Stefan1623/VoidLink_Hardware/RP2350_V2/JLCPCB_stackup_info.png

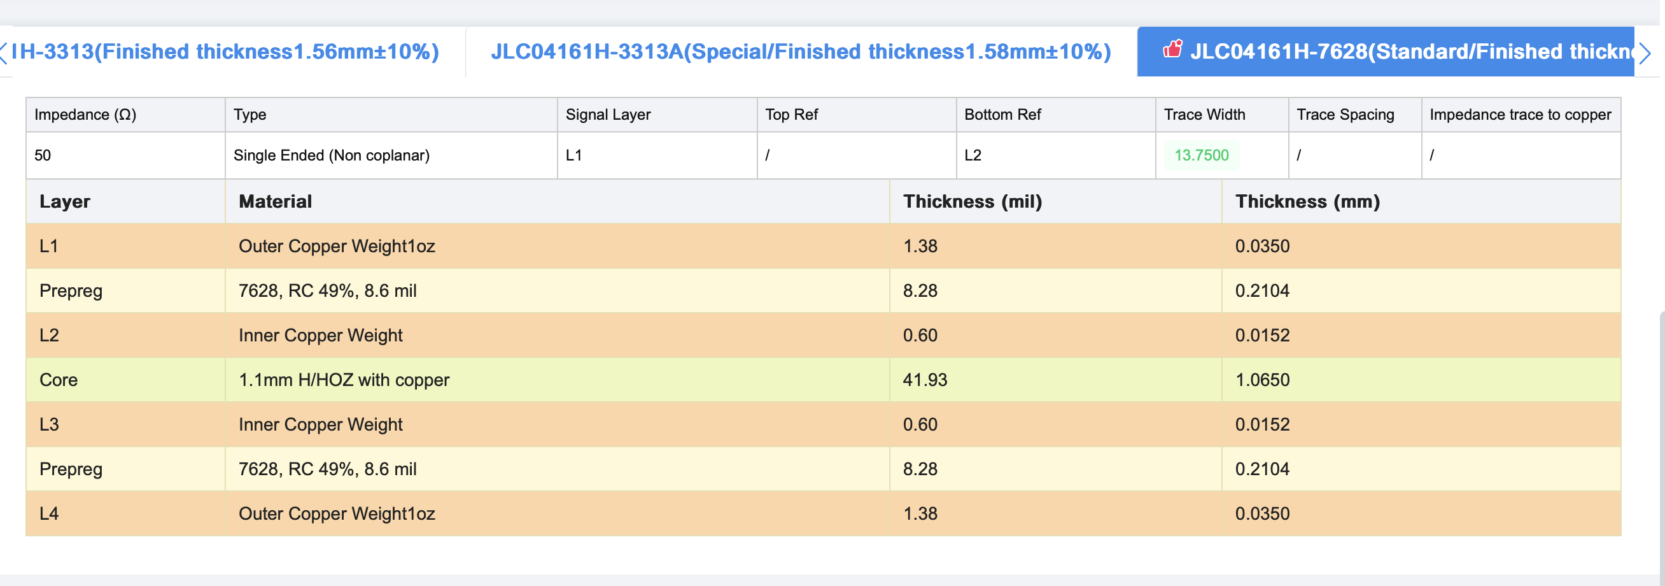
RP2350_V2/JLCPCB_stackup_info.png
