Stefan1623/VoidLink_Hardware/RP2350_V2/3dmodels/My_Caps/CAP_CL05_SAM.step

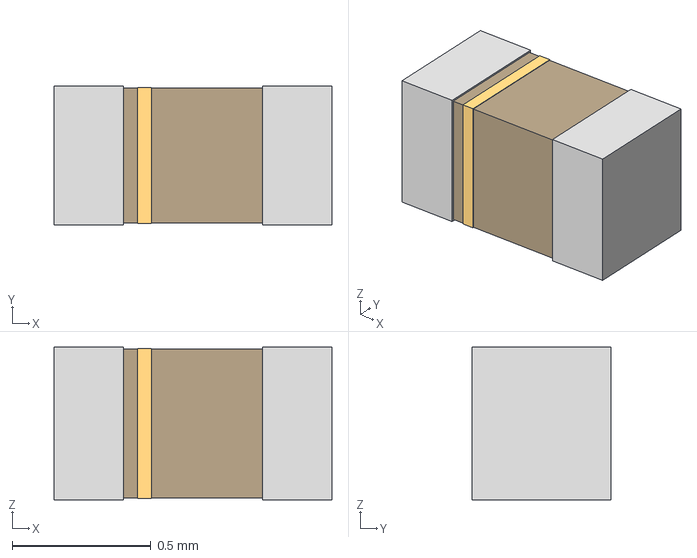
[picture p2: CAD file, 2025-02-19]
RP2350_V2/3dmodels/My_Caps/CAP_CL05_SAM.step
1.00 x 0.5 x 0.55 mm
