Stefan1623/VoidLink_Hardware/RP2350_V2/3dmodels/My_ESD/SMFSeries_LTF.step

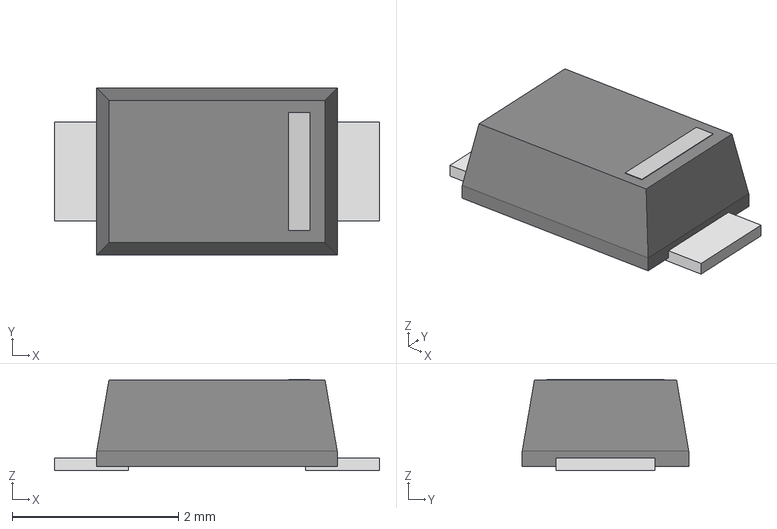
[picture p3: CAD file, 2025-02-19]
RP2350_V2/3dmodels/My_ESD/SMFSeries_LTF.step
3.91 x 2.01 x 1.10 mm
