Stefan1623/VoidLink_Hardware/RP2350_V2/3dmodels/My_ICs/DCK0006A.stp

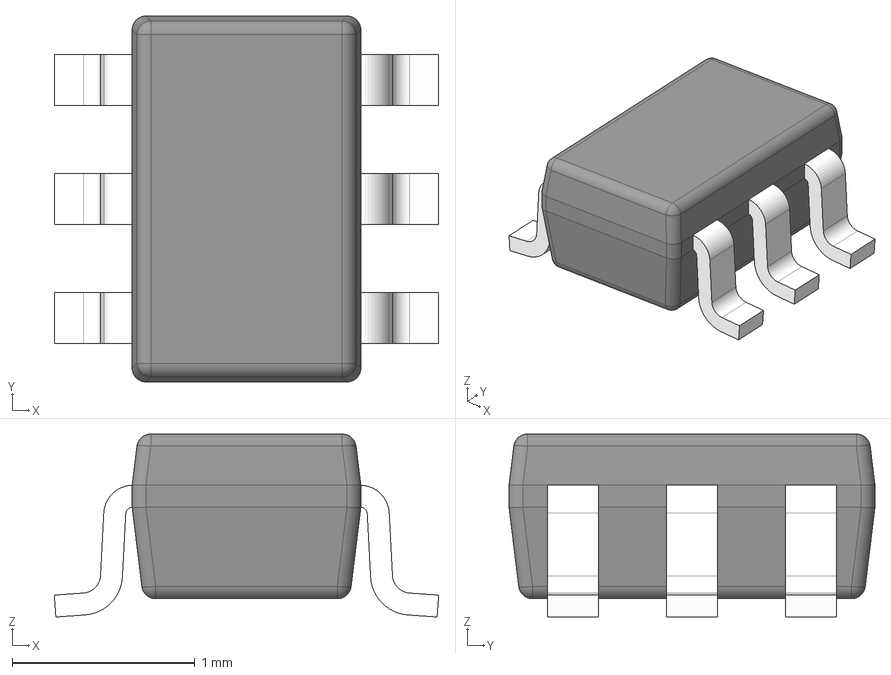
[picture p4: CAD file, 2025-02-19]
RP2350_V2/3dmodels/My_ICs/DCK0006A.stp
2.10 x 2.00 x 1.00 mm
BODY-SOT
LEAD-SOT x 6
PIN1-ID
