Stefan1623/VoidLink_Hardware/RP2350_V2/3dmodels/My_Inductors/AOTA-B201610S3R3-101-T/AOTA-B201610S3R3-101-T.stp

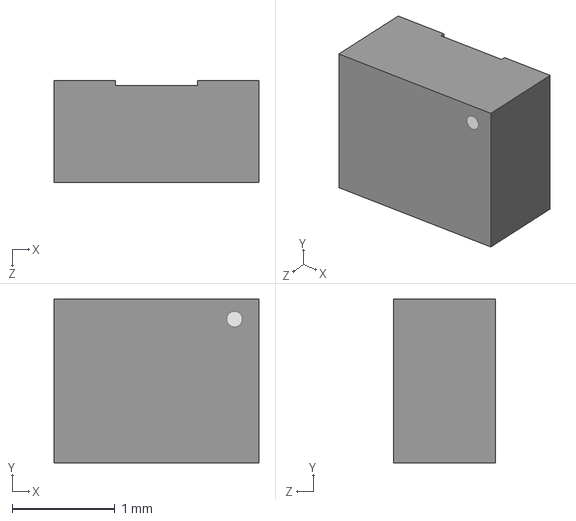
[picture p5: CAD file, 2025-01-27]
RP2350_V2/3dmodels/My_Inductors/AOTA-B201610S3R3-101-T/AOTA-B201610S3R3-101-T.stp
2.00 x 1.60 x 1.00 mm
