Stefan1623/VoidLink_Hardware/RP2350_V2/3dmodels/My_LEDs/LTST-C191KFKT.step

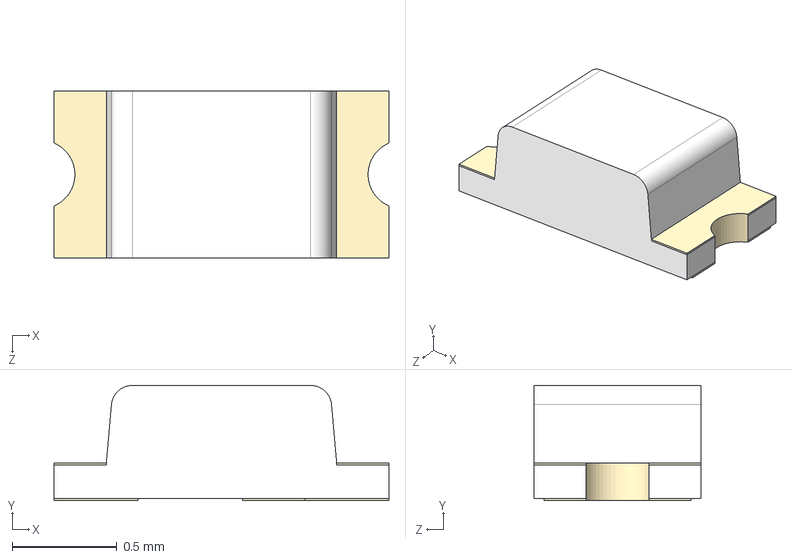
[picture p6: CAD file, 2025-02-16]
RP2350_V2/3dmodels/My_LEDs/LTST-C191KFKT.step
1.60 x 0.55 x 0.8 mm
