Stefan1623/VoidLink_Hardware/RP2350_V2/3dmodels/My_MOSFETS/DMP1045U-7.stp

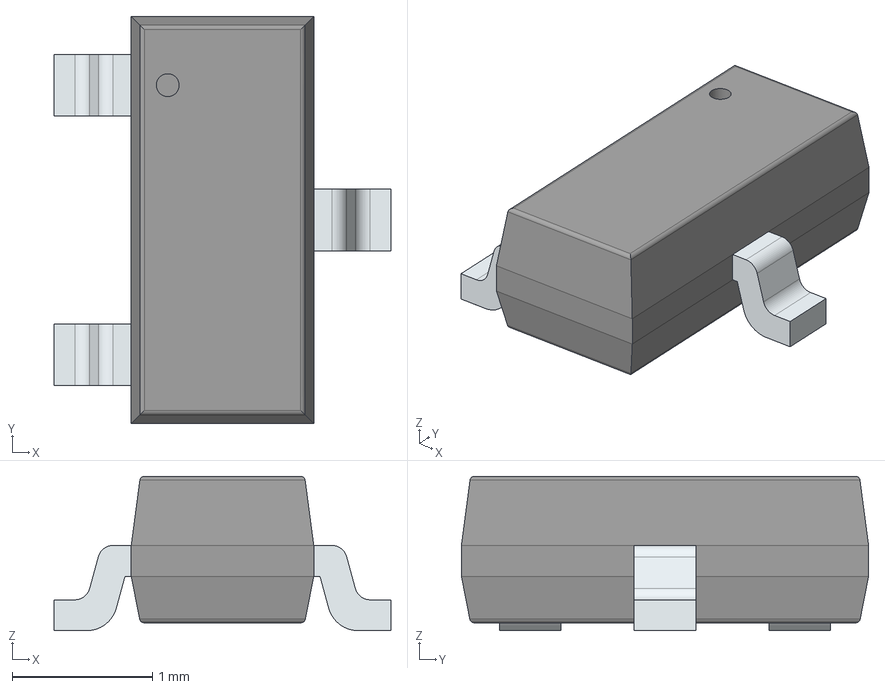
[picture p7: CAD file, 2025-02-12]
RP2350_V2/3dmodels/My_MOSFETS/DMP1045U-7.stp
2.40 x 2.90 x 1.10 mm
PinsArrayL
FilletPinR
