Stefan1623/VoidLink_Hardware/RP2350_V2/3dmodels/My_Potentiometers/P090S-14T20BR10K.stp

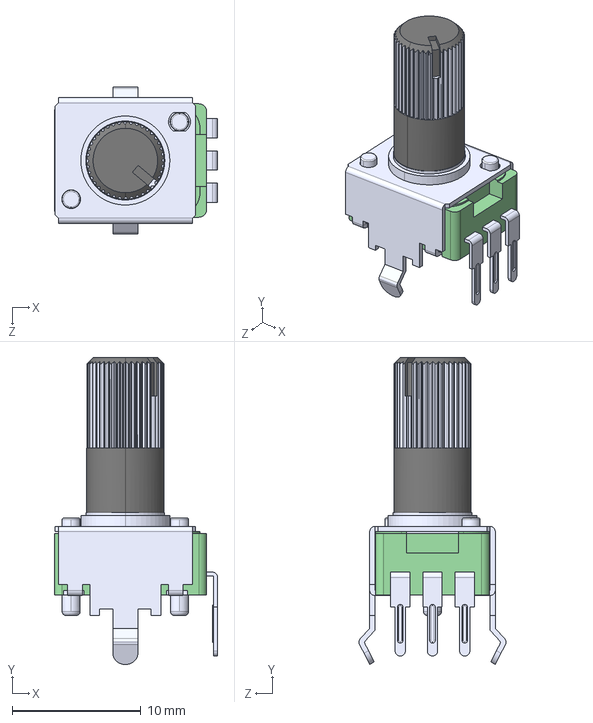
[picture p8: CAD file, 2025-01-27]
RP2350_V2/3dmodels/My_Potentiometers/P090S-14T20BR10K.stp
12.7 x 23.8 x 11.4 mm
