Stefan1623/VoidLink_Hardware/RP2350_V2/3dmodels/My_Pushbuttons/PTS 647 SN70 SMTR2 LFS.STEP

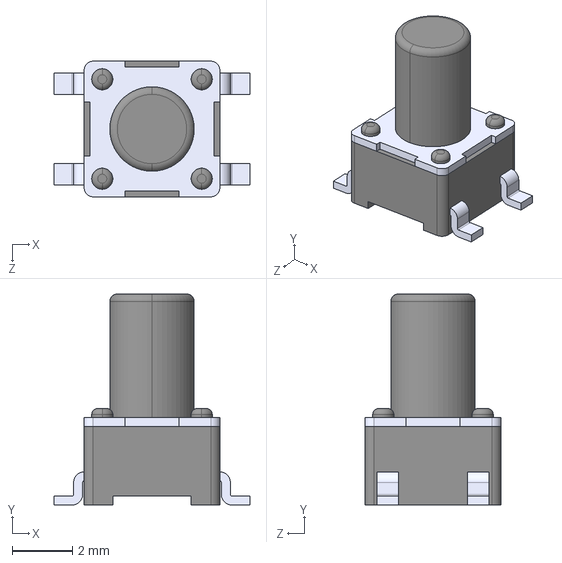
[picture p9: CAD file, 2025-02-19]
RP2350_V2/3dmodels/My_Pushbuttons/PTS 647 SN70 SMTR2 LFS.STEP
6.50 x 7.00 x 4.50 mm
