Stefan1623/VoidLink_Hardware/RP2350_V2/3dmodels/My_Xtals/ABM8-272-T3_ABR.step

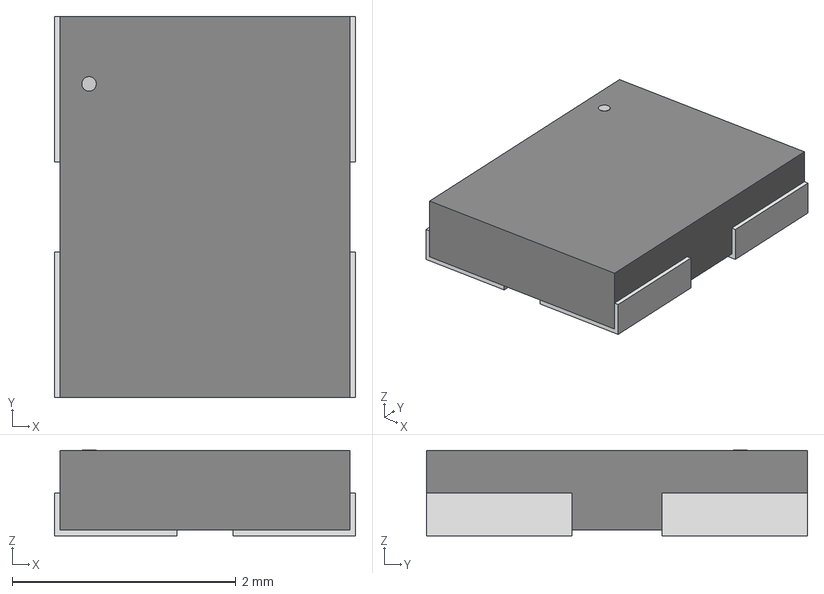
[picture p10: CAD file, 2025-02-19]
RP2350_V2/3dmodels/My_Xtals/ABM8-272-T3_ABR.step
2.69 x 3.40 x 0.765 mm
