Stefan1623/VoidLink_Hardware/RP2350_V2/3dmodels/My_ESD/ESD7L5.0DT5G.stp

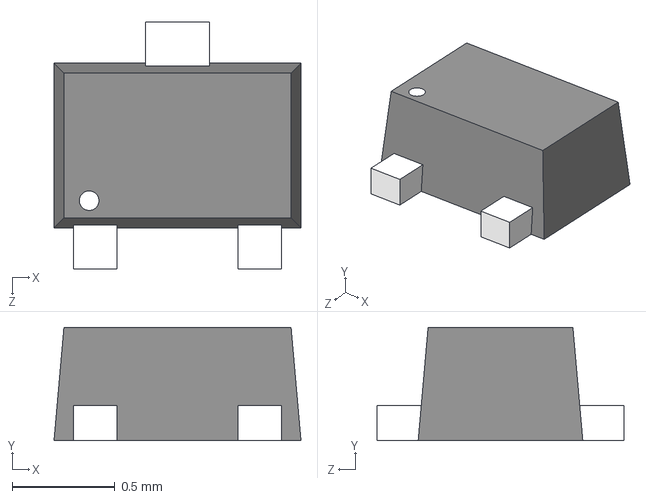
[picture p11: CAD file, 2025-01-27]
RP2350_V2/3dmodels/My_ESD/ESD7L5.0DT5G.stp
1.20 x 0.55 x 1.20 mm
