Stefan1623/VoidLink_Hardware/RP2350_V2/3dmodels/My_ICs/SOIC_128JVSIQ_WIN.step

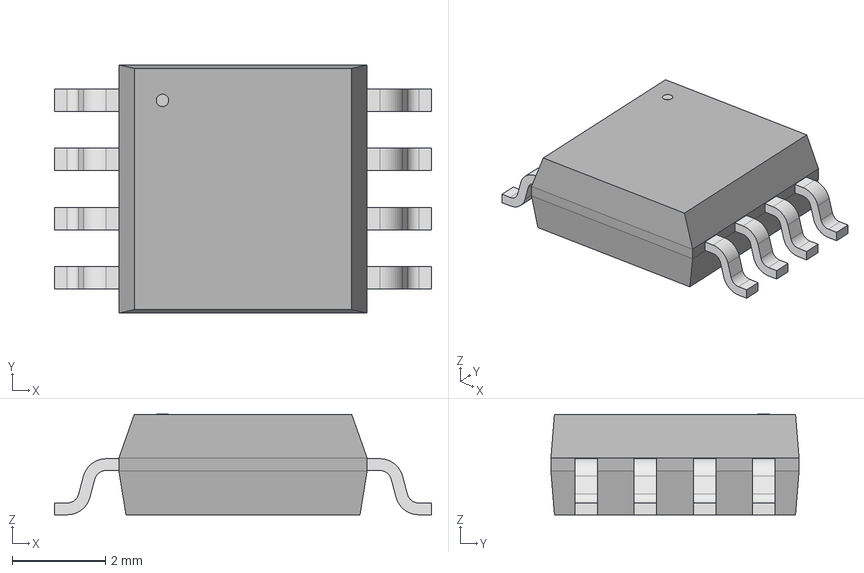
[picture p12: CAD file, 2025-02-19]
RP2350_V2/3dmodels/My_ICs/SOIC_128JVSIQ_WIN.step
8.10 x 5.33 x 2.16 mm
