Stefan1623/VoidLink_Hardware/RP2350_V2/3dmodels/My_LEDs/LTST-C190KRKT.step

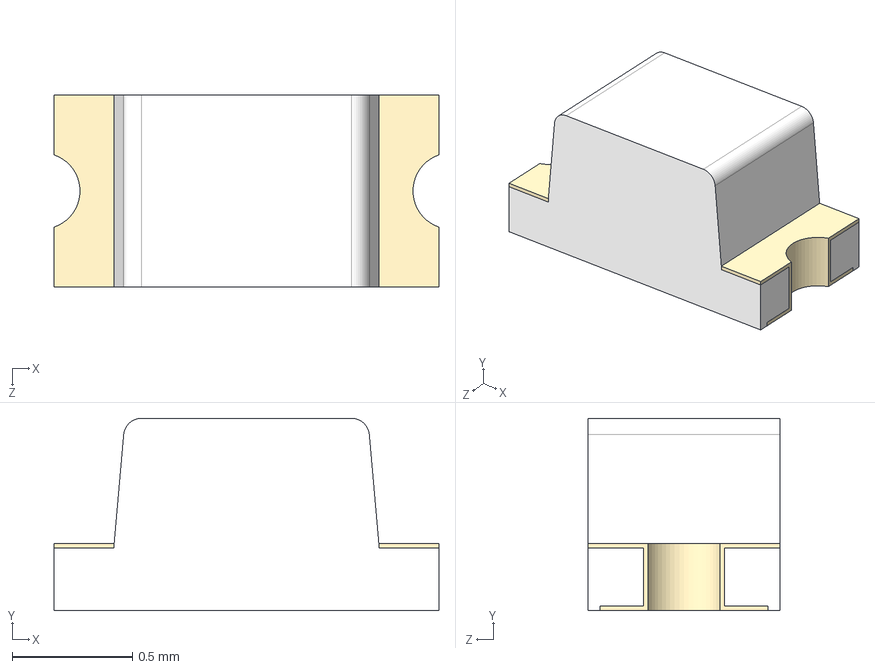
[picture p13: CAD file, 2025-02-16]
RP2350_V2/3dmodels/My_LEDs/LTST-C190KRKT.step
1.60 x 0.8 x 0.8 mm
