Stefan1623/VoidLink_Hardware/RP2350_V2/3dmodels/My_Pushbuttons/PTS 647 SM50 SMTR2 LFS.STEP

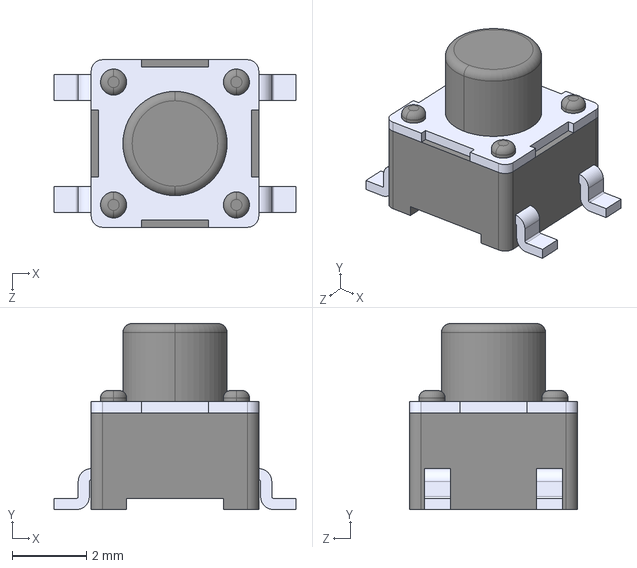
[picture p14: CAD file, 2025-02-12]
RP2350_V2/3dmodels/My_Pushbuttons/PTS 647 SM50 SMTR2 LFS.STEP
6.50 x 5.00 x 4.50 mm
