Stefan1623/VoidLink_Hardware/RP2350_V2/3dmodels/My_Xtals/ASE-12.000MHZ-ET.stp

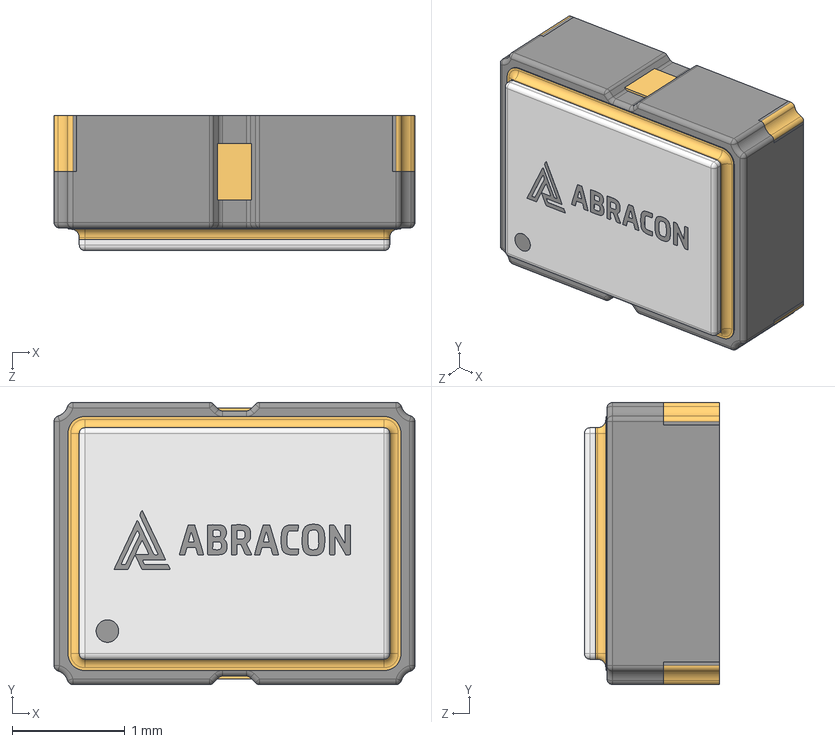
[picture p15: CAD file, 2025-02-12]
RP2350_V2/3dmodels/My_Xtals/ASE-12.000MHZ-ET.stp
3.20 x 2.50 x 1.20 mm
ASE-25.000MHZ-LR-T
Abracon New Logo
