Stefan1623/VoidLink_Hardware/RP2350_V2/3dmodels/My_ICs/RWY0009C.stp

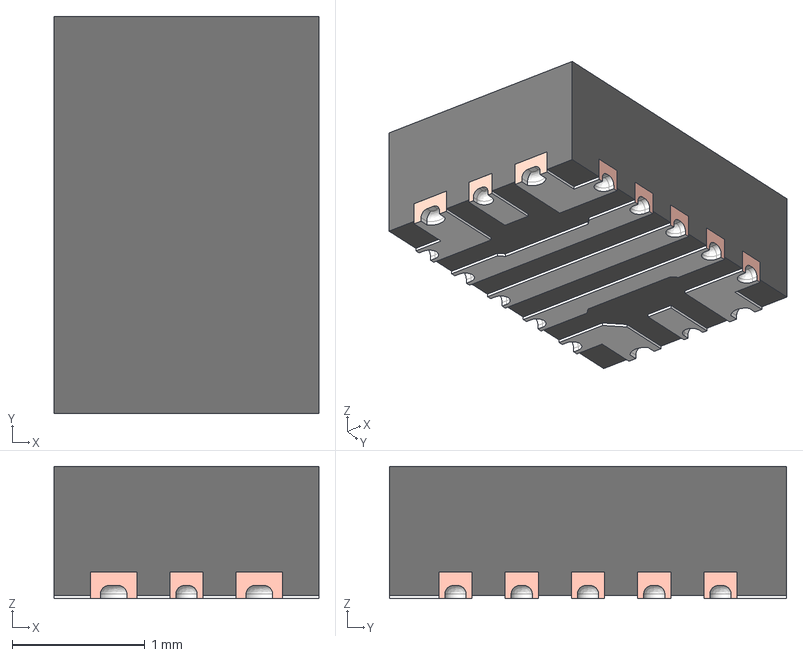
[picture p16: CAD file, 2025-02-15]
RP2350_V2/3dmodels/My_ICs/RWY0009C.stp
2.00 x 3.00 x 1.00 mm
FRAME-RWY0009C
BODY-QFN
PIN1-ID
