Stefan1623/VoidLink_Hardware/RP2350_V2/3dmodels/My_LEDs/LTST-C190TBKT.step

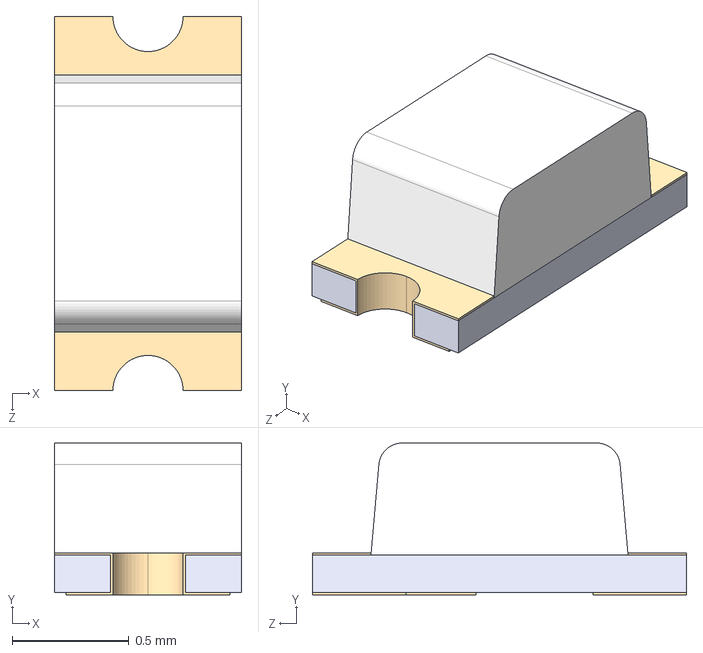
[picture p17: CAD file, 2025-02-16]
RP2350_V2/3dmodels/My_LEDs/LTST-C190TBKT.step
0.8 x 0.65 x 1.60 mm
