Stefan1623/VoidLink_Hardware/RP2350_V2/3dmodels/My_ICs/DBV0006A.stp

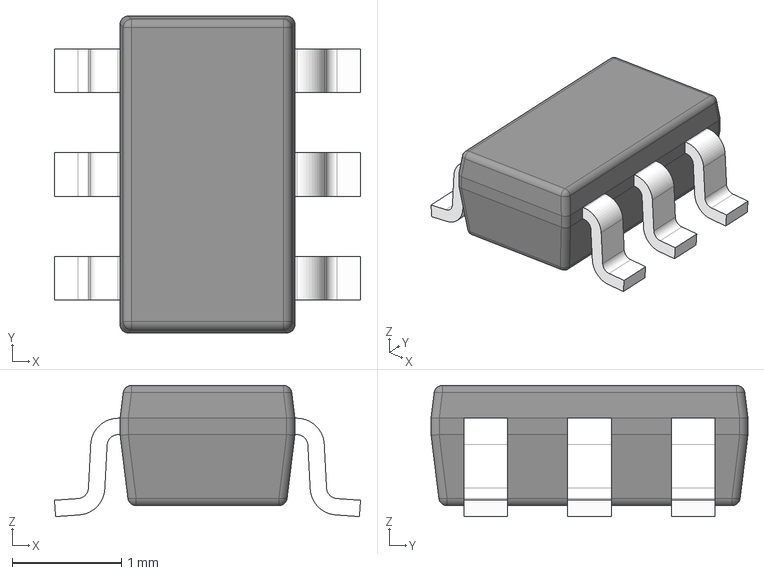
[picture p18: CAD file, 2025-02-15]
RP2350_V2/3dmodels/My_ICs/DBV0006A.stp
2.80 x 2.90 x 1.20 mm
BODY-SOT
LEAD-SOT x 6
