Stefan1623/VoidLink_Hardware/RP2350_V2/3dmodels/My_ICs/W25Q128JVSIQ.stp

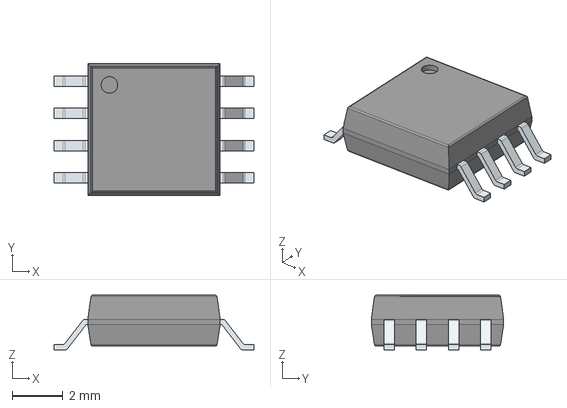
[picture p19: CAD file, 2025-02-12]
RP2350_V2/3dmodels/My_ICs/W25Q128JVSIQ.stp
7.90 x 5.23 x 2.16 mm
PinsArrayLR
