Stefan1623/VoidLink_Hardware/RP2350_V2/3dmodels/My_ICs/RP2350A-QFN60.step

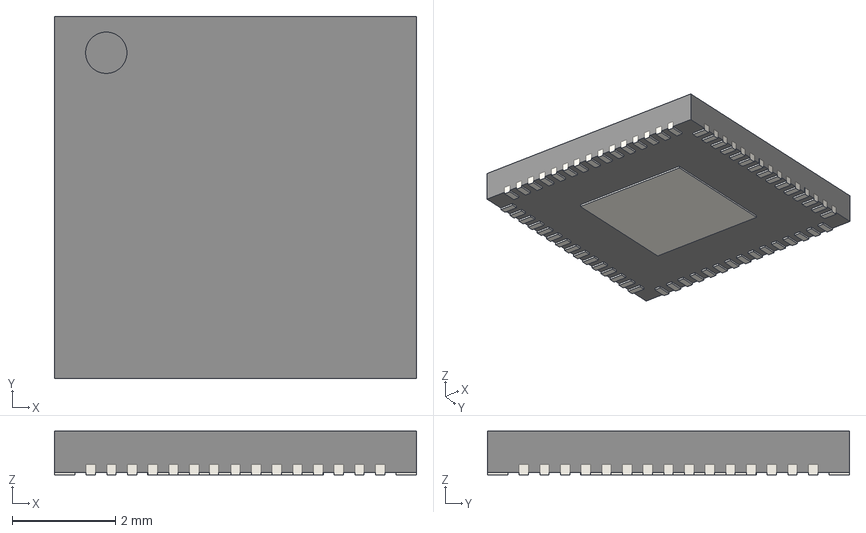
[picture p20: CAD file, 2025-02-12]
RP2350_V2/3dmodels/My_ICs/RP2350A-QFN60.step
7.00 x 7.00 x 0.85 mm
