Stefan1623/VoidLink_Hardware/RP2350_V2/3dmodels/My_ICs/SN74HC14DR.stp

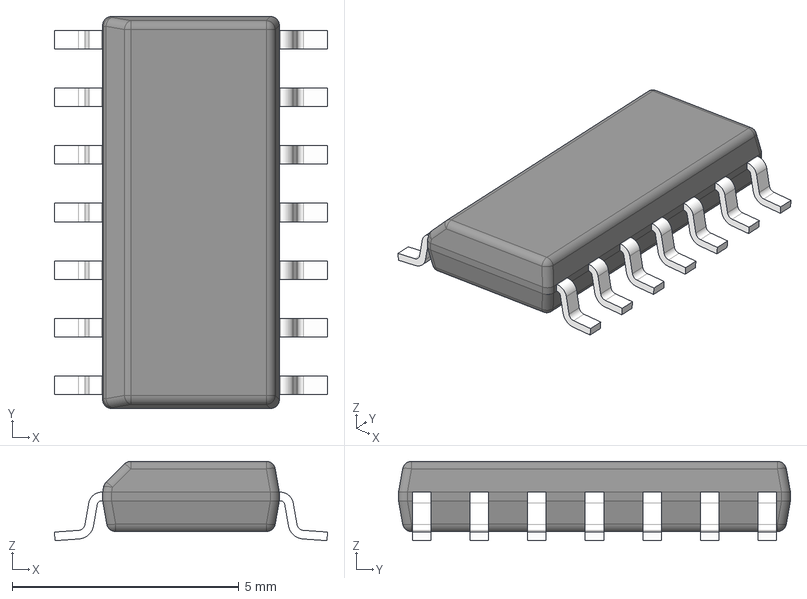
[picture p21: CAD file, 2025-02-12]
RP2350_V2/3dmodels/My_ICs/SN74HC14DR.stp
6.03 x 8.65 x 1.75 mm
BODY-SO
LEAD-SO x 14
PIN1-ID
