Stefan1623/VoidLink_Hardware/RP2350_V2/RP2350_V2.kicad_pcb

## KiCad design RP2350_V2/RP2350_V2.kicad_pcb (2025-03-18)

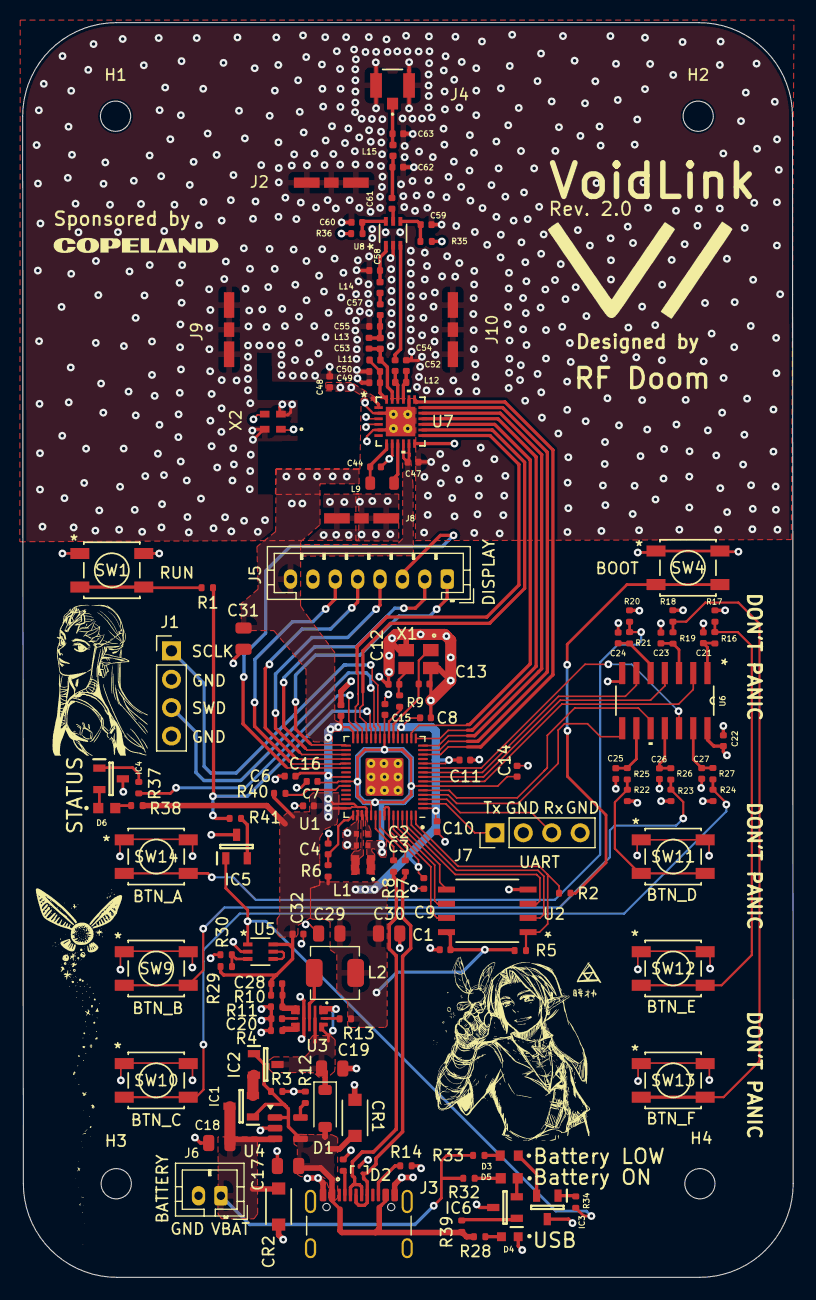
[picture p22: board RP2350_V2.kicad_pcb from above]

Board: 4 copper layers, 68.9 x 112.1 mm, 142 parts (0 on the bottom side), 102 nets.

Parts:
C1, C5, C6, C7, C8, C9, C10, C11, C14, C16, C47: 100n; C_0402_1005Metric
C2, C3: 4.7u; C_0402_1005Metric_small_pads
C4, C15: 4.7u; C_0402_1005Metric
C12, C13: 15p; C_0402_1005Metric
C17, C18: 4.7u; C_0805_2012Metric
C19, C30, C31: 22u; C_0805_2012Metric
C20: 4.7n; C_0402_1005Metric
C21, C22, C23, C24, C25, C26, C27, C32: 0.1u; C_0402_1005Metric
C28: 10p; C_0402_1005Metric
C29: 10u; C_0805_2012Metric
C44: 470n; C_0402_1005Metric
C48: 1u; C_0402_1005Metric
C49: 47n; C_0402_1005Metric
C50: 47p; C_0402_1005Metric
C52, C58: 1.8p; C_0402_1005Metric
C53: 3p; C_0402_1005Metric
C54: 2.4p; C_0402_1005Metric
C55: 5.6p; C_0402_1005Metric
C57, C61: 39p; C_0402_1005Metric
C59, C60: 1n; C_0402_1005Metric
C62, C63: 3.3p; C_0402_1005Metric
CR1, CR2: SMF12CA; SMFSeries_SOD-123F
D1: MBR0520LT; D_SOD-123
D2: ESD7L5.0DT5G; SOT-723_0P85X1P25_ONS-L
D3: LTW-C193DS5-ND; LEDC1608X35N_red
D4: LTST-C190TBKT; LEDM1608X80_blue
D5: LTST-C193TGKT-5A; LEDC1608X55N_orange
D6: LTST-C191KFKT; LEDC1608X55N_orange
H1, H2, H3, H4: MountingHole; MountingHole_2.7mm_M2.5
IC1, IC2, IC3, IC4, IC5, IC6: DMP1045U-7; SOT96P240X110-3N
J1, J7: Conn_01x04_Pin; PinHeader_1x04_P2.54mm_Vertical
J2, J8, J9, J10: S0991-46R; HARWIN_S0991-46R
J3: USB_C_Receptacle_USB2.0_16P; USB_C_Receptacle_GCT_USB4105-xx-A_16P_TopMnt_Horizontal
J4: IPEX1; MHF I_RECE_IPX
J5: Conn_01x08_Socket; JST_PH_B8B-PH-K_1x08_P2.00mm_Vertical
J6: Conn_01x02_Pin; JST_PH_B2B-PH-K_1x02_P2.00mm_Vertical
L1: 3.3u; AOTA-B201610S3R3-101-T
L2: 560n; L_Changjiang_FXL0420
L9: 15u; L_0805_2012Metric
L11: 47n; L_0402_1005Metric
L12: 15n; L_0402_1005Metric
L13: 2.5n; L_0402_1005Metric
L14: 4.7n; L_0402_1005Metric
L15: 9.1n; L_0402_1005Metric
R1, R2, R9, R40, R41: 1k; R_0402_1005Metric
R3, R13, R34, R37, R39: 100k; R_0402_1005Metric
R4: 8.06k; R_0402_1005Metric
R5, R12, R16, R17, R18, R19, R20, R21, R22, R23, R24, R25, R26, R27: 10k; R_0402_1005Metric
R6: 33; R_0402_1005Metric
R7, R8: 27; R_0402_1005Metric
R10: 88.7k; R_0402_1005Metric
R11: 19.6k; R_0402_1005Metric
R14, R15: 5.1k; R_0402_1005Metric
R28: 110; R_0402_1005Metric
R29: 1.5Meg; R_0402_1005Metric
R30: 1Meg; R_0402_1005Metric
R32: 91; R_0402_1005Metric
R33: 20; R_0402_1005Metric
R35, R36: 100; R_0402_1005Metric
R38: 51; R_0402_1005Metric
SW1, SW4, SW9, SW10, SW11, SW12, SW13, SW14: PTS 647 SN50 SMTR2 LFS
U1: RP2350_60QFN; RP2350-QFN-60-1EP_7x7_P0.4mm_EP3.4x3.4mm_ThermalVias_NEW
U2: W25Q128JVS; SOIC_128JVSIQ_WIN
U3: TPS62811QWRWYRQ1; RWY0009A
U4: MCP73812T-420I-OT; SOT-23-5
U5: TLV3012AIDCKR; DCK6
U6: 74HC14; SN74HC14DR_D14
U7: SX1262_QFN24_4X4_SEM
U8: PE4259_RF_SW
X1: ABM8-272-T3; ABM8-272-T3_ABR
X2: NX2016SA-32M-EXS00A-CS06465; NX2016SA_NDK

Connections:
+1V1: C3.1, C14.1, C15.1, C16.1, L1.1, U1.6 (DVDD), U1.23 (DVDD), U1.39 (DVDD), U1.50 (VREG_FB)
+3V3: C1.1, C2.1, C5.1, C6.1, C7.1, C8.1, C9.1, C10.1, C11.1, C22.2, C28.1, C29.1, C30.1, C31.1, C32.1, C47.2, C48.2, J5.8, L2.2, R5.1, R6.1, R10.1, R13.1, R17.1, R18.1, R20.1, R22.1, R23.1, R24.1, R29.1, R36.2, R38.1, R40.2, U1.1 (IOVDD), U1.11 (IOVDD), U1.20 (IOVDD), U1.30 (IOVDD), U1.38 (IOVDD), U1.44 (ADC_AVDD), U1.45 (IOVDD), U1.49 (VREG_VIN), U1.53 (USB_OTP_VDD), U1.54 (QSPI_IOVDD), U2.8 (VCC), U5.6 (V+), U6.14 (VCC), U7.1 (VDD_IN), U7.10 (VBAT), U7.11 (VBAT_IO)
/BTN_BACK: U1.7 (GPIO4), U6.2
/BTN_MACRO_A: U1.4 (GPIO2), U6.8
/BTN_MACRO_B: U1.5 (GPIO3), U6.10
/BTN_MACRO_C: U1.10 (GPIO7), U6.12
/BTN_NEXT: U1.9 (GPIO6), U6.6
/BTN_OK: U1.8 (GPIO5), U6.4
/COMP_FSET: R4.1, U3.7 (COMP_FSET)
/Converter_In: C19.1, D1.1 (K), IC2.3 (D), U3.1 (MODE_SYNC), U3.2 (VIN), U3.8 (EN)
/Converter_Out: L2.1, U3.3 (SW)
/DISPLAY_BUSY: J5.1, U1.31 (GPIO19)
/DISPLAY_DC: J5.3, U1.36 (GPIO24)
/DISPLAY_RESET: J5.2, U1.32 (GPIO20)
/FB: C28.2, R10.2, R11.1, U3.5 (FB)
/PG: R13.2, U3.9 (PG)
/QSPI_SCLK: U1.56 (QSPI_SCLK), U2.6 (CLK)
/QSPI_SD0: U1.57 (QSPI_SD0), U2.5 (DI(IO0))
/QSPI_SD1: U1.59 (QSPI_SD1), U2.2 (DO(IO1))
/QSPI_SD2: U1.58 (QSPI_SD2), U2.3 (IO2)
/QSPI_SD3: U1.55 (QSPI_SD3), U2.7 (IO3)
/QSPI_SS: R2.2, R5.2, U1.60 (QSPI_SS), U2.1 (~CS)
/RUN: R1.2, R41.2, U1.26 (RUN)
/RUN_IN: R1.1, SW1.3, SW1.4
/SPI1_CLK: J5.5, U1.34 (GPIO22)
/SPI1_CS: J5.4, U1.33 (GPIO21)
/SPI1_TX: J5.6, U1.35 (GPIO23)
/STATUS_LED: R37.1, U1.29 (GPIO18)
/SWCLK: J1.1, U1.24 (SWCLK)
/SWD: J1.3, U1.25 (SWD)
/SX1262/DIO2: R35.2, U7.12 (DIO2)
/SX1262/VR_PA: C49.2, C50.2, L11.2, U7.24 (VR_PA)
/SX1262/XTA: U7.3 (XTA), X2.3
/SX1262/XTB: U7.4 (XTB), X2.1
/UART_Rx_DEBUG: J7.3, U1.3 (GPIO1)
/UART_Tx_DEBUG: J7.1, U1.2 (GPIO0)
/USB_CC1: J3.A5 (CC1), R15.1
/USB_CC2: J3.B5 (CC2), R14.1
/USB_D+: D2.2 (K), J3.A6 (D+), J3.B6 (D+), R7.1
/USB_D-: D2.1 (K), J3.A7 (D-), J3.B7 (D-), R8.1
/UVLO_RST: IC5.1 (G), R34.1, U5.1 (OUT)
/VBAT: C18.1, CR2.1, IC1.3 (D), J6.1, R32.1, R33.1, U4.3 (V_{BAT})
/VREG_AVDD: C4.1, R6.2, U1.46 (VREG_AVDD)
/VREG_LX: L1.2, U1.48 (VREG_LX)
/XIN: C13.1, U1.21 (XIN), X1.1
/XOUT: R9.2, U1.22 (XOUT)
/~USB_BOOT: R2.1, SW4.3, SW4.4
CS/NSS: U1.13 (GPIO9), U7.19 (NSS)
DIO1: U1.28 (GPIO17), U7.13 (DIO1)
GND: C1.2, C2.2, C3.2, C4.2, C5.2, C6.2, C7.2, C8.2, C9.2, C10.2, C11.2, C12.1, C13.2, C14.2, C15.2, C16.2, C17.2, C18.2, C19.2, C20.2, C21.2, C22.1, C23.2, C24.2, C25.2, C26.2, C27.2, C29.2, C30.2, C31.2, C32.2, C44.1, C47.1, C48.1, C49.1, C50.1, C52.1, C55.1, C58.1, C59.2, C60.2, C62.1, C63.1, CR1.2, CR2.2, D2.3 (A), D4.C, IC3.3 (D), IC4.3 (D), IC5.3 (D), IC6.3 (D), J1.2, J1.4, J2.SH1 (SHIELD), J2.SH2 (SHIELD__1), J2.SH3 (SHIELD__2), J3.A1 (GND), J3.A12 (GND), J3.B1 (GND), J3.B12 (GND), J4.1, J4.2, J5.7, J6.2, J7.2, J7.4, J8.SH1 (SHIELD), J8.SH2 (SHIELD__1), J8.SH3 (SHIELD__2), J9.SH1 (SHIELD), J9.SH2 (SHIELD__1), J9.SH3 (SHIELD__2), J10.SH1 (SHIELD), J10.SH2 (SHIELD__1), J10.SH3 (SHIELD__2), R3.2, R4.2, R11.2, R12.2, R14.2, R15.2, R30.2, SW1.1, SW1.2, SW4.1, SW4.2, SW9.1, SW9.2, SW10.1, SW10.2, SW11.1, SW11.2, SW12.1, SW12.2, SW13.1, SW13.2, SW14.1, SW14.2, U1.47 (VREG_PGND), U1.61 (GND), U2.4 (GND), U3.4 (GND), U4.2 (V_{SS}), U5.2 (V-), U6.7 (GND), U7.2 (GND), U7.5 (GND), U7.8 (GND), U7.20 (GND), U7.25 (GND), U8.2 (GND), X1.2, X1.4, X2.2, X2.4
unnamed: C12.2, R9.1, X1.3
unnamed: C21.1, R16.2, U6.1
unnamed: C23.1, R19.2, U6.3
unnamed: C24.1, R21.2, U6.5
unnamed: C25.1, R25.2, U6.9
unnamed: C26.1, R26.2, U6.11
unnamed: C27.1, R27.2, U6.13
unnamed: C53.1, C55.2, C57.2, L13.2
unnamed: C57.1, L14.1
unnamed: C61.1, C62.2, L15.1
unnamed: C63.2, J4.3, L15.2
unnamed: D3.A, R33.2
unnamed: D4.A, R28.2
unnamed: D5.A, R32.2
unnamed: D6.A, R38.2
unnamed: IC1.2 (S), IC2.2 (S)
unnamed: IC3.1 (G), R34.2
unnamed: D3.C, IC3.2 (S)
unnamed: IC4.1 (G), R37.2
unnamed: D6.C, IC4.2 (S)
unnamed: IC5.2 (S), R41.1
unnamed: IC6.1 (G), R39.2
unnamed: D5.C, IC6.2 (S)
unnamed: R16.1, R17.2, SW12.3, SW12.4
unnamed: R18.2, R19.1, SW13.3, SW13.4
unnamed: R20.2, R21.1, SW14.3, SW14.4
unnamed: R22.2, R25.1, SW11.3, SW11.4
unnamed: R23.2, R26.1, SW9.3, SW9.4
unnamed: R24.2, R27.1, SW10.3, SW10.4
unnamed: R40.1, U1.40 (GPIO26_ADC0)
unnamed: R8.2, U1.51 (USB_DM)
unnamed: R7.2, U1.52 (USB_DP)
unnamed: C20.1, U3.6 (SS_TR)
unnamed: R12.1, U4.5 (PROG)
unnamed: R29.2, R30.1, U5.3 (IN+)
unnamed: U5.4 (IN-), U5.5 (REF)
unnamed: L9.2, U7.9 (DCC_SW)
unnamed: C54.2, L12.2, U7.22 (RFI_N)
unnamed: C52.2, L12.1, U7.21 (RFI_P)
unnamed: C53.2, L11.1, L13.1, U7.23 (RFO)
unnamed: C44.2, L9.1, U7.7 (VREG)
unnamed: C60.1, R36.1, U8.6 (*CTRL/VDD)
unnamed: C59.1, R35.1, U8.4 (CTRL)
unnamed: C58.2, L14.2, U8.1 (RF1)
unnamed: C54.1, U8.3 (RF2)
unnamed: C61.2, U8.5 (RFC)
SPI0_CLK: U1.14 (GPIO10), U7.18 (SCK)
SPI0_TX: U1.15 (GPIO11), U7.17 (MOSI)
SPIO_RX: U1.16 (GPIO12), U7.16 (MISO)
VBUS: C17.1, CR1.1, D1.2 (A), IC1.1 (G), IC2.1 (G), J3.A4 (VBUS), J3.A9 (VBUS), J3.B4 (VBUS), J3.B9 (VBUS), R3.1, R28.1, R39.1, U4.1 (CE), U4.4 (V_{DD})
uC_BUSY: U1.27 (GPIO16), U7.14 (BUSY)
uC_RESET: U1.17 (GPIO13), U7.15 (NRESET)
