Stefan1623/VoidLink_Hardware/(commit log)

2025-01-27 V1 init
    [AOTA-B201610S3R3-101-T.stp, ESD7L5.0DT5G.stp, P090S-14T20BR10K.stp, RP2350_V1.kicad_pcb, RP2350_V1.kicad_sch]
2025-02-12 new power sch, rough lay floorplan
    [ASE-12.000MHZ-ET.stp, DMP1045U-7.stp, PTS 647 SM50 SMTR2 LFS.STEP, RP2350A-QFN60.step, RP2350_V1.kicad_pcb, RP2350_V1.kicad_sch, SN74HC14DR.stp, W25Q128JVSIQ.stp]
2025-02-15 First pass routing done! MCU pin updates. UVLO Reset resistor update
    [DBV0006A.stp, RP2350_V1.kicad_pcb, RP2350_V1.kicad_sch, RWY0009C.stp]
2025-02-16 Added LEDs, edege cuts, silkscreen logo
    next steps --> DRC
    [LTST-C190KRKT.step, LTST-C190TBKT.step, LTST-C191KFKT.step, RP2350_V1.kicad_pcb]
2025-02-16 DRC Clean (with waivers)
    Added manual vias to RP2350 GND pad.
    Silkscreen updates.
    Remaining DRCs seem waivable (TPS62811 footprint bug, USB C through holes, RP2350 footprint corners)
    [RP2350_V1.kicad_pcb, RP2350_V1.kicad_sch]
2025-02-19 sch updates, lay in progress
    updated TLV3012 package,
    changed cmos oscillator to xtal,
    updated LCSC component values for all non-generic components
    [ABM8-272-T3_ABR.step, DCK0006A.stp, PTS 647 SN70 SMTR2 LFS.STEP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]
2025-02-19 xtal lay done, JLC_DFM clean
    [CAP_CL05_SAM.step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]
2025-02-19 DONOT USE PREVIOUS VERSIONS! *Fixed TLV3012*, added TVS diodes
    [RP2350_V1.kicad_pcb, RP2350_V1.kicad_sch, SMFSeries_LTF.step]
2025-02-20 Updated TVS diode to bi-directional version (SMF12CA)
    [RP2350_V1.kicad_pcb, RP2350_V1.kicad_sch]
2025-02-20 updated LED resistors, re-exported fabrication outputs
    [RP2350_V1-B_Cu.gbr, RP2350_V1-B_Mask.gbr, RP2350_V1-Edge_Cuts.gbr, RP2350_V1-F_Cu.gbr, RP2350_V1-F_Mask.gbr, RP2350_V1-F_Paste.gbr, RP2350_V1-F_Silkscreen.gbr, RP2350_V1-In1_Cu.gbr]
2025-02-21 caps added
    [RP2350_V1.kicad_sch]
2025-02-21 Rs added
    [RP2350_V1.kicad_sch]
2025-02-22 try again for BOM?
    [RP2350_V1.csv, RP2350_V1.kicad_sch]
2025-02-26 updated manufacturing files, added orientation marker to TPS62811 in lay, no fiducial markers
    jlcpcb engineer asked me to confirm the orientation of the tps ic, i guess thats why we use pin 1 markers (flushed.png)
    [RP2350_V1-B_Cu.gbr, RP2350_V1-B_Mask.gbr, RP2350_V1-Edge_Cuts.gbr, RP2350_V1-F_Cu.gbr, RP2350_V1-F_Mask.gbr, RP2350_V1-F_Paste.gbr, RP2350_V1-F_Silkscreen.gbr, RP2350_V1-In1_Cu.gbr]
2025-02-27 MAJOR FIX - RP2350 unconnected 3V3, GND pins - previous versions will NOT work
    rip
    [RP2350_V1.kicad_pcb]
2025-02-27 now rev1.1; improvements to 1v1 net, cleanup, local drc looks good
    lmnop
    [RP2350_V1-B_Cu.gbr, RP2350_V1-B_Mask.gbr, RP2350_V1-Edge_Cuts.gbr, RP2350_V1-F_Cu.gbr, RP2350_V1-F_Mask.gbr, RP2350_V1-F_Paste.gbr, RP2350_V1-F_Silkscreen.gbr, RP2350_V1-In1_Cu.gbr]
2025-03-04 initial transceier sch
    [RP2350_V1.kicad_sch, SX1262kicad_sch.kicad_sch]
2025-03-06 Rev 2.0 added. Ready to start transceiver layout.
    [ABM8-272-T3_ABR.step, AOTA-B201610S3R3-101-T.stp, ASE-12.000MHZ-ET.stp, CAP_CL05_SAM.step, DBV0006A.stp, DCK0006A.stp, DMP1045U-7.stp, ESD7L5.0DT5G.stp]
2025-03-07 Transceiver components and schematic final?
    [RP2350_V1.kicad_sch, RP2350_V2.csv, RP2350_V2.kicad_sch, SX1262kicad_sch.csv, SX1262kicad_sch.kicad_sch]
2025-03-08 initial Transceiver layout
    [RP2350_V2.kicad_pcb, SX1262kicad_sch.kicad_sch]
2025-03-10 progress :D
    [RP2350_V2.kicad_pcb, RP2350_V2.kicad_sch, SX1262kicad_sch.kicad_sch]
2025-03-10 VIASgit add --allgit add --all
    [RP2350_V2.kicad_pcb]
2025-03-13 rev2 progress
    [RP2350_V2.kicad_pcb, RP2350_V2.kicad_sch]
2025-03-16 Lots of Updatesgit add --allgit add --all
    [RP2350_V2.kicad_pcb, RP2350_V2.kicad_sch]
2025-03-16 optimizations, refinements
    [RP2350_V2.kicad_pcb, RP2350_V2.kicad_sch, SX1262kicad_sch.kicad_sch]
2025-03-16 added 3V3 input to ADC, fixed edge cut DRCs
    [RP2350_V2.kicad_pcb, RP2350_V2.kicad_sch]
2025-03-17 DFM progress
    [RP2350_V2-B_Cu.gbr, RP2350_V2-B_Mask.gbr, RP2350_V2-Edge_Cuts.gbr, RP2350_V2-F_Cu.gbr, RP2350_V2-F_Mask.gbr, RP2350_V2-F_Paste.gbr, RP2350_V2-F_Silkscreen.gbr, RP2350_V2-In1_Cu.gbr]
2025-03-17 vias smh my head
    [RP2350_V2.kicad_pcb]
2025-03-17 final push?
    [RP2350_V2-B_Cu.gbr, RP2350_V2-B_Mask.gbr, RP2350_V2-Edge_Cuts.gbr, RP2350_V2-F_Cu.gbr, RP2350_V2-F_Mask.gbr, RP2350_V2-F_Paste.gbr, RP2350_V2-F_Silkscreen.gbr, RP2350_V2-In1_Cu.gbr]
2025-03-17 fix display pins on mcu
    [RP2350_V2-B_Cu.gbr, RP2350_V2-B_Mask.gbr, RP2350_V2-Edge_Cuts.gbr, RP2350_V2-F_Cu.gbr, RP2350_V2-F_Mask.gbr, RP2350_V2-F_Paste.gbr, RP2350_V2-F_Silkscreen.gbr, RP2350_V2-In1_Cu.gbr]
2025-03-18 dfdjfjh pt2
    [RP2350_V2.kicad_sch, SX1262kicad_sch.kicad_sch]
2025-03-18 fixed RF impedance matched width, changed rf connector, etc.
    DRC+DFM clean with waivers. Pending final review for tapeout.
    [RP2350_V2-B_Cu.gbr, RP2350_V2-B_Mask.gbr, RP2350_V2-Edge_Cuts.gbr, RP2350_V2-F_Cu.gbr, RP2350_V2-F_Mask.gbr, RP2350_V2-F_Paste.gbr, RP2350_V2-F_Silkscreen.gbr, RP2350_V2-In1_Cu.gbr]
2025-03-18 update XTAL1 to X2, regen fab exports
    [RP2350_V2-B_Cu.gbr, RP2350_V2-B_Mask.gbr, RP2350_V2-Edge_Cuts.gbr, RP2350_V2-F_Cu.gbr, RP2350_V2-F_Mask.gbr, RP2350_V2-F_Paste.gbr, RP2350_V2-F_Silkscreen.gbr, RP2350_V2-In1_Cu.gbr]
2025-03-18 via refinement
    [RP2350_V2.kicad_pcb]
2025-03-18 rev2.0 tapeout
    [RP2350_V2-B_Cu.gbr, RP2350_V2-B_Mask.gbr, RP2350_V2-Edge_Cuts.gbr, RP2350_V2-F_Cu.gbr, RP2350_V2-F_Mask.gbr, RP2350_V2-F_Paste.gbr, RP2350_V2-F_Silkscreen.gbr, RP2350_V2-In1_Cu.gbr]
2025-03-18 tapeout files included, updated D3, D5 LCSC values (change reflected in order)
    [RP2350_V2.kicad_sch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]
